espressif/kicad-libraries/template/ESP32-DevKitC/meta/board.png

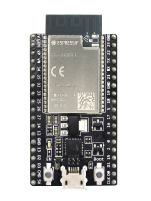
template/ESP32-DevKitC/meta/board.png
