espressif/kicad-libraries/template/ESP32-DevKitC/meta/module.png

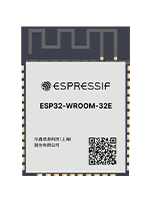
template/ESP32-DevKitC/meta/module.png
