espressif/kicad-libraries/(threads)

Thread 1 (2021-07-04):

Can you contribute the ESP32 library to the KiCad repository?

taotieren, 2021-07-04:
Can you contribute the ESP32 library to the [KiCad repository](https://gitlab.com/kicad/libraries)?

https://www.kicad.org/libraries/contribute/
https://www.kicad.org/libraries/klc/

pedrominatel, 2021-07-06:
Hi @taotieren, we are working on the first version of this library to include all commercial SoC and modules.
As soon as we have the first version available, we can do that.

taotieren, 2021-07-06:
I hope to contribute these libraries to the library warehouse before V6 is released, so that V6 users can directly use the ESP library to make PCB files

pedrominatel, 2021-07-06:
For sure @taotieren!

Closed 2021-07-15.

Thread 3 (2021-07-14):

Can't open footprint lib

TDA-2030, 2021-07-14:
## Environment

Application: KiCad
Version: 5.1.8-5.1.8, release build
Libraries:
    wxWidgets 3.0.3
    libcurl/7.66.0 OpenSSL/1.1.1d-fips zlib/1.2.11 libidn2/2.2.0 libpsl/0.20.1 (+libidn2/2.2.0) libssh/0.8.7/openssl/zlib nghttp2/1.40.0
Platform: Linux 5.3.18-lp152.78-default x86_64, 64 bit, Little endian, wxGTK
Build Info:
    wxWidgets: 3.0.3 (wchar_t,STL containers,compatible with 2.8) GTK+ 2.24
    Boost: 1.66.0
    OpenCASCADE Technology: 7.3.0
    Curl: 7.66.0
    Compiler: GCC 7.5.0 with C++ ABI 1011

Build settings:
    USE_WX_GRAPHICS_CONTEXT=OFF
    USE_WX_OVERLAY=OFF
    KICAD_SCRIPTING=ON
    KICAD_SCRIPTING_MODULES=ON
    KICAD_SCRIPTING_PYTHON3=OFF
    KICAD_SCRIPTING_WXPYTHON=ON
    KICAD_SCRIPTING_WXPYTHON_PHOENIX=OFF
    KICAD_SCRIPTING_ACTION_MENU=ON
    BUILD_GITHUB_PLUGIN=ON
    KICAD_USE_OCE=OFF
    KICAD_USE_OCC=ON
    KICAD_SPICE=ON

## Description

I can't open the footprint `Dev_ESP32-S2-Saola-1.kicad_mod` on commit `c8e7b4fa07bac0`. I guess the version is not compatible. Which version of kicad is used for testing?

Following is the error prompt:
```
11:27:22 AM: file '~/Desktop/kicad-libraries/footprints/Espressif.pretty/Dev_ESP32-S2-Saola-1.kicad_mod', line 1: '=' expected.
11:27:22 AM: file '~/Desktop/kicad-libraries/footprints/Espressif.pretty/Dev_ESP32-S2-Saola-1.kicad_mod', line 2: '=' expected.
11:27:22 AM: file '~/Desktop/kicad-libraries/footprints/Espressif.pretty/Dev_ESP32-S2-Saola-1.kicad_mod', line 3: '=' expected.
11:27:22 AM: file '~/Desktop/kicad-libraries/footprints/Espressif.pretty/Dev_ESP32-S2-Saola-1.kicad_mod', line 4: '=' expected.
11:27:22 AM: file '~/Desktop/kicad-libraries/footprints/Espressif.pretty/Dev_ESP32-S2-Saola-1.kicad_mod', line 5: '=' expected.
11:27:22 AM: file '~/Desktop/kicad-libraries/footprints/Espressif.pretty/Dev_ESP32-S2-Saola-1.kicad_mod', line 6: '=' expected.
11:27:22 AM: file '~/Desktop/kicad-libraries/footprints/Espressif.pretty/Dev_ESP32-S2-Saola-1.kicad_mod', line 7: '=' expected.

Omit similar logs
```

pedrominatel, 2021-07-14:
Hi @TDA-2030.

The library is now for the KiCad v6 (5.99).

My version is: Version: **5.99.0-unknown-395602b12a~131~ubuntu20.04.1, release build**

pedrominatel, 2021-07-14:
@TDA-2030 can you try the legacy branch?

https://github.com/espressif/kicad-libraries/tree/legacy

TDA-2030, 2021-07-15:
I have opened the footprint with KiCad v5.99. It should really be a version compatibility issue. Are the footprints of these two branches the same?

BTW, I'm adding `ESP32-DevKitc` and `ESP32-S3-DevKitc` to this library as well. If you think it is necessary, I will submit a PR :grin:

pedrominatel, 2021-07-16:
Hi @TDA-2030, thank you for collaborating!

For now, I'm using the `legacy` branch in order to be compatible with V5. Later, we can convert it easily to V6 or let the user do that.
The `feature/new_libraries` will not be updated anymore due to this compatibility issue with V5.

If you already managed to create the libs for the DevKitC on V6 version, you can create the PR on the `feature/new_libraries` and I can convert it back to V5 on the `legacy` branch. Otherwise I will close that branch and keep the `legacy` instead.

TDA-2030, 2021-07-16:
I will create the PR on `legacy` , because KiCad(v5.99) seems to work unsteadily on my computer.

Closed 2021-07-16.

Thread 5 (2021-07-18):

README is confusing

blackketter, 2021-07-18:
It's not clear when you arrive on the GitHub page for this library where the referenced footprints and symbols are.

I suggest that either:

The README.md should be updated to reference the appropriate branches
or

Include the 5.0-compatible files in the Main branch and leave the 6.0 versions in a branch to be merged later (after 6.0 is released)

or

Include folders for each major version of KiCAD in the Main branch

pedrominatel, 2021-07-18:
Thanks @blackketter for the feedback. We will improve that.

The `legacy` will be merged soon to main and all KiCad V6 libs will be removed.

Closed 2021-09-22.

Thread 8 (2021-07-26):

Document how to get 3D models working correctly

blackketter, 2021-07-26:
I see the 3d models in the repository, but they are not referenced correctly in the footprint files.  There seems to be a missing ${ESPRESSIF_3DMODELS} definition in the path.  This should be documented in the README as part of installation instructions.

Ideally, there would be a default relative path that would work without any further setup, but I don't think Kicad5 has a facility for this.

pedrominatel, 2021-07-27:
Thanks for the feedback. We'll include this step on README.

Closed 2021-09-22.

Thread 9 (2021-07-30):

Please add ESP-C3-32S

rtreffer, 2021-07-30:
Not sure if this is the right way to ask for it but I was hoping to see footprints for the ESP-C3-32S.

Please add a footprint for that chip (38p with 0.05mm less bottom space than the other WROOMS)

Spritetm, 2021-08-08:
That is an AI-Thinker product as far as I can see, not an Espressif product. You may be better off asking AI-Thinker for a symbol/footprint.

MauroMombelli, 2023-09-16:
@Spritetm if I make a merge request, would it be accepted or this repo is only for official layout?

Spritetm, 2023-09-17:
@MauroMombelli I'm no the owner of this repo, but I don't think so... it would be very hard for us to check and maintain footprints for products that are not ours.

Closed 2021-08-08.

Thread 10 (2021-08-05):

Symbol ESP32-S3-WROOM-1 wrong name

TDA-2030, 2021-08-05:
## Description
The two names in the red box are different
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

pedrominatel, 2021-08-10:
Thanks for pointing this out @TDA-2030. This will be fixed soon.

pedrominatel, 2021-08-10:
PTAL @TDA-2030 before merging.

https://github.com/espressif/kicad-libraries/pull/13

TDA-2030, 2021-08-11:
LGTM :)

Closed 2021-08-12.

Thread 15 (2021-08-21):

WROOM and WROVER symbols are swapped

hhtat, 2021-08-21:
The ESP32-WROOM-E and ESP32-WROVER-E symbols seems to be swapped. This can be verified by looking at GPIO16 & GPIO17. On WROVER these should be NC (due to PSRAM) but are connected. On WROOM these should be connect but marked NC.

pedrominatel, 2021-08-21:
Thanks for reporting this issue @hhtat

Closed 2021-08-21.

Thread 18 (2021-10-11):

Can you add the library about ESP32-C3-MINI-1U and ESP32-C3-WROOM-02U

McflyWZX, 2021-10-11:
Although they have the same symbol with which module not "U", but their footprint and the 3D model are not same. That will make many help!

pedrominatel, 2021-11-02:
New footprint added, PTAL @McflyWZX.

McflyWZX, 2021-11-03:
Very thank you

Closed 2021-11-02.

Thread 22 (2021-11-02):

ESP32-S3-MINI-1 symbol references "ESP32-S3-WROVER"

atanisoft, 2021-11-02:
A rather minor issue in the symbol:
https://github.com/espressif/kicad-libraries/blob/b40df1bc7486e5b6350e0c265a6b5adb9419a549/libraries/Espressif.lib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

pedrominatel, 2021-11-05:
Thanks for your feedback @atanisoft. This will be fixed soon.

Closed 2021-11-10.

Thread 24 (2021-11-18):

ESP32-S3-MINI-1 footprint pad 46 not connecting to GND net

atanisoft, 2021-11-18:
All GND pads connect except the non-square pad in the center:
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

Checking that specific pad shows that it is explicitly configured to not connect to nets.

pedrominatel, 2021-11-19:
Thank you for your feedback. I'll check it ASAP.

pedrominatel, 2021-11-19:
Hi @atanisoft, KiCad does not support thermal relief on custom shape pads. You can add manually or edit the pad characteristics by double-clicking on the custom pad and setting.

Pad Properties -> Connection to Copper Zone -> Pad Connection -> Solid

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

If this works for you, you can close this issue.

Thank you!

atanisoft, 2021-11-19:
@pedrominatel That is rather unfortunate on the KiCad side, but understandable considering the reason why (thermal relief spokes would be challenging to calculate on random polygons). After reading your suggestion I went looking for options to augment the footprint so it can fill automatically like others and one suggestion was to add a second pad (square or circle) that is smaller than the custom pad and stack them. I'll see if I can modify the footprint to have a smaller pad on top of this one and confirm if it works and doesn't generate any unnecessary DRC alerts.

pedrominatel, 2021-11-19:
This smaller pad technique works very well in most of the cases. If you want, you can create a PR for the S3 and we can replicate it for the others.

atanisoft, 2021-11-19:
I'll send a PR in a bit after confirming no DRC related alerts

atanisoft, 2021-11-19:
@pedrominatel in my testing of stacked footprints locally it doesn't seem to connect to the copper fill. I'm thinking your alternative above may be a better option and include it by default in the footprint.

Minimal diff:
```
   (pad 46 smd custom (at -1.65 -1.65) (size 0.6 0.6) (layers F.Cu F.Paste F.Mask)
-    (zone_connect 0)
+    (zone_connect 2)
```

For whatever reason KiCad wants to reorder all of the `fp_line` entries in the footprint which makes little sense since they are the same values just reordered.

pedrominatel, 2021-11-22:
Hi @atanisoft, I can modify that in my next review. I think it's a good idea to add some notes about it on the `README.md` in order to explain this KiCad 5 limitation. Not sure if this happens on KiCad 6.

Closed 2021-12-01.

Thread 25 (2021-11-23):

ESP32-WROOM-32E GPIO 16 and GPIO 17 have no connection flags

Monacrylic, 2021-11-23:
IOs 16 and 17 have a no connection flag, while they shouldn't (looking at the datasheet).

pedrominatel, 2021-12-13:
Fixed! Thank you @Monacrylic

Closed 2021-12-13.

Thread 26 (2021-11-23):

ESP32-C3-WROOM-02U 3D model

BitSalat, 2021-11-23:
Would be great to have a 3D model (step) for the -02U module (without PCB antenna)
as well as we are just implementing it in a commercial design - thank you a lot.

alank-hisky, 2021-11-23:
Found a possible 3rd party solution "ESP-WROOM-02U" STEP file
https://www.3dcontentcentral.com/secure/download-model.aspx?catalogid=171&id=999269
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

pedrominatel, 2022-01-19:
The 3D model will be added on the next revision.

Here is the 3D model: https://www.espressif.com/sites/default/files/3dmodel/ESP32-C3-WROOM-02U_20210906_0.STEP

pedrominatel, 2022-03-04:
Done!

Thread 29 (2021-12-27):

Prepare KiCad 6 port

pedrominatel, 2021-12-27:
Prepare libraries to KiCad 6.

- Test current libraries.
- Convert to KiCad 6.
- Test

atanisoft, 2021-12-31:
In my limited testing so far with KiCad 6 the libs appear to be working without problems.

pedrominatel, 2022-01-10:
Thank you for testing @atanisoft! I'm also testing without any problems so far.

Closed 2022-03-04.

Thread 40 (2022-04-13):

No ground for exposed pad (pin 39) on schematic symbol

crashmatt, 2022-04-13:
How to connect pin 39 GND?
The ESP32-S2-WROOM schematic and footprint has this option on pin 43.

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

crashmatt, 2022-04-13:
Fixed in the KiCad V6 library.  Closing.

Closed 2022-04-13.

Thread 41 (2022-04-26):

ESP32-S3-WROOM-1 has wrong pin label

Li-Huakang, 2022-04-26:
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
duplicated

pedrominatel, 2022-05-02:
Thanks, @Li-Huakang for your collaboration!

Closed 2022-05-02.

Thread 44 (2022-05-08):

do you can add altium libraries for it

yuyue2013, 2022-05-08:
I use the altium for drawing board.  but the esp32 don't have the altium libraries. do you can add altium libraries of esp32?  thanks!

TianmingLi, 2022-05-24:
if you use altium, you can get everything from [lceda](https://lceda.cn/editor). also there are lot tutorial for how to do it.

pedrominatel, 2022-06-15:
Hi,

Espressif does not have any plans in the near future for adding the Altium libraries.

Closed 2022-06-15.

Thread 46 (2022-06-23):

ESP32-WROOM symbol description wrong (describes the WROVER)

ESP-Marius, 2022-06-23:
The ESP32-WROOM symbol description seems to be a copy of the WROVER description.

pedrominatel, 2022-06-23:
Thanks @ESP-Marius, I'll fix it ASAP.

Closed 2022-07-11.

Thread 49 (2022-07-01):

ESP32-S3-WROOM2

higaski, 2022-07-01:
Any chance we can expect the WROOM2 versions of the S3 modules any time soon? From what I've seen they have slightly rearranged ground pads in the middle compared to the WROOM1.

pedrominatel, 2022-07-11:
Hi @higaski,

The [ESP32-S3-WROOM-2](https://www.espressif.com/sites/default/files/documentation/esp32-s3-wroom-2_datasheet_en.pdf) will be added according to the datasheet landing pattern.

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

higaski, 2022-07-11:
Ok, let me rephrase my question.

In case I need a footprint of this part within the next 2-3 weeks, should I better draw it myself or can I count on you guys doing it. :stuck_out_tongue_closed_eyes:

pedrominatel, 2022-07-11:
We can manage that in the next week or soon.

pedrominatel, 2022-07-29:
Done, @higaski. PTAL

Closed 2022-07-29.

Thread 50 (2022-07-07):

Fix ESP32-C3-MINI-1/U modules outline dimensions

pedrominatel, 2022-07-07:
[Datasheet](https://www.espressif.com/sites/default/files/documentation/esp32-c3-mini-1_datasheet_en.pdf)

Related to #48

pedrominatel, 2022-07-08:
Fixed on PR #48

Closed 2022-07-08.

Thread 56 (2022-08-21):

esp32-mini-1 symbol / footprint

tenderlove, 2022-08-21:
Hi,

I'm working on a project that incorporates the [esp32-mini-1](https://www.espressif.com/sites/default/files/documentation/esp32-mini-1_datasheet_en.pdf), and I was wondering if there is a KiCad symbol / footprint available for that module?  I don't see one in this repository, but I would be happy to make one if there is a similar module I can copy from.

Any help would be greatly appreciated.

Thanks!

pedrominatel, 2022-08-23:
Thanks, @tenderlove. We can provide the new footprint/symbol for this new module.
This module has a different landing pad number from all the other MINI versions. Copy is not possible.

tenderlove, 2022-08-23:
@pedrominatel awesome, thank you!!! 😍

tenderlove, 2022-10-10:
@pedrominatel thanks for fixing this!  I don't see the mini-1 in the repo though.  Am I missing something?  Thanks.

Closed 2022-10-28.

Thread 57 (2022-09-02):

Adherence to KiCad Library Conventions

JustinOng, 2022-09-02:
Hello,

Can I find out if there are plans to have the symbols to adhere to the [KiCad Library Conventions](https://klc.kicad.org/symbol/)? The two specifically I've noticed on the ESP32-WROOM-E:

- S4.1, point 1, where the pin origin should lie on a 100mil grid
- S4.3, point 3, where pins of the same type (mostly GND) should be stacked together

pedrominatel, 2022-09-26:
Hi @JustinOng, thank you for the concern. I'll review this issue and make the changes.

pedrominatel, 2022-10-31:
Can you take a look at PR #61, @JustinOng?

Closed 2022-11-02.

Thread 58 (2022-09-11):

Models for ESP32-S3-MINI-1U and ESP8684-MINI-1-H4

GTCLive, 2022-09-11:
Hi guys, would it be possible to update this repo with the latest step files for S3 and C2, please?
Those are the modules we've recently bought and can't find them in the repo.
No rush neither an impediment in getting PCB done.
Would be nice to have that's all.
Thanks

ESP32-S3-MINI-1U
ESP8684-MINI-1-H4
ESP8684-WROOM-01C-H4

pedrominatel, 2022-10-31:
Done, @GTCLive.

Closed 2022-10-29.

Thread 59 (2022-10-11):

3D model of ESP32-S3-WROOM-1U

dangvitin, 2022-10-11:
I think the 3D model for **ESP32-S3-WROOM-1U** is not correct.

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

pedrominatel, 2022-10-25:
Thank you @dangvitin, for reporting this issue.
I'll take a look.

pedrominatel, 2022-10-28:
Hi,

In fact, this 3D model is the wrong one and will be removed from the 3D folder. The correct one will be uploaded as soon as possible.

Closed 2023-01-03.

Thread 62 (2022-11-07):

Thermal pads of ESP32-WROOM-E at wrong location?

timcooijmans, 2022-11-07:
Hi,

Our PCBA house noted a mismatch (both in X and Y location as size) between the thermal pads of ESP32-WROOM-E in this library and the datasheet (in red):
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

Footprint 8.32mm to center of thermal pads:
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

Datasheet 7.5mm to center of thermal pads:
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

Same applies in the vertical direction and the size of the pads themselves.

pedrominatel, 2022-11-21:
Thank you, @timcooijmans,  for your feedback. This issue has been fixed and merged.
Please check it out.

Closed 2022-11-21.

Thread 65 (2022-12-07):

Feature Request: Add KICAD Library to Offical PCM (Package and Plugin Manager)

philippdonabauer, 2022-12-07:
### Kicad PCM (Plugin and Content Manager) Feature Request

Kicad now provides the possibility to add custom footprint / content libraries to a Plugin Manager. This provide the users the possibility to simple install Offical released versions of your content library. It also helps you to be one of the first "microcontroller" on the platform that also means that you can arrive more and new customers.

Here an screenshot of the library manager, which i think is one of the biggest new features:

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

The documentation is simple to understand: https://dev-docs.kicad.org/en/addons/

I would love to see this package in the plugin manager in the future. I maybe also can help a little bit if you don't have the time to do that.

Thank you very much.

pedrominatel, 2022-12-12:
Hi @philippdonabauer,

This has been on my to-do list for a while. I'll start working on that by Jan/Feb 23.

pedrominatel, 2022-12-19:
Hi, @philippdonabauer. It will be great if you contribute to this project! Go ahead!
Many thanks for your help!

dronecz, 2023-01-17:
@philippdonabauer Any progress with this? Many thanks for your work! :heart:

cooked, 2023-01-30:
@philippdonabauer I've developed a gitHub action to automate packaging of Kicad addon... maybe it can help your case. let me know if you try it out and need help
https://github.com/marketplace/actions/publish-kicad-addon

cheers

pedrominatel, 2023-02-07:
Thank you @philippdonabauer for your help!

As I understood, you are able to install via the ZIP file but you can't find the package in the libraries search, is that correct?

pedrominatel, 2023-02-07:
One good example we can follow is the `keyswitch-kicad-library` from @perigoso: https://github.com/perigoso/keyswitch-kicad-library

Is there anything you can help us with, @perigoso?

perigoso, 2023-02-07:
Hi, probably, but i would need to understand the problem first, I'll take a look at the end of the day

perigoso, 2023-02-10:
Sorry, I didn't have time and then forgot...

I'm sorry to inform you I have nothing to add. :sweat_smile:

Your branch looks good, the generated package has the correct structure and everything looks good, it installs and I can find the libraries just fine.

Do make sure the libraries are in the footprint and symbol library tables, in Preferences, when the feature was added libraries were not added automatically, but right now I think they are supposed to.

perigoso, 2023-02-22:
IMO the patch is good to go as is, the problem is either a bug on the version of KiCad you are using or some configuration issue

JarrettR, 2023-04-19:
Hi,

Is this good to just create a PR?

JarrettR, 2023-04-20:
Works fine on Windows

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

Added quick rough directions on how to submit to KiCad. It's from memory, so it's possible it's not fully complete, but the gist of it is there.

Closed 2023-06-07.

Thread 67 (2023-01-07):

ESP32-C3-MINI-1 missing pin 11 & 14

shanemmattner, 2023-01-07:
I keep getting errors for missing `pin 11/14`.

```
Warning: No net found for symbol U1 pin 14.
Warning: No net found for symbol U1 pin 11.
```

Upon inspecting the schematic symbol I think these pins are missing and should be with the rest of the ground pins:

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

Closed 2023-01-10.

Thread 71 (2023-01-20):

Fix the KLC S4.2 for all symbols

pedrominatel, 2023-01-20:
Fix the pin grouping rule for all symbols.

https://klc.kicad.org/symbol/s4/s4.2/

Reference: #70

Closed 2024-04-22.

Thread 74 (2023-01-30):

ESP32-WROOM symbol missing GND pins

cooked, 2023-01-30:
library version 1.1.0 pin missing:
- pin 15
- pin 38

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

pedrominatel, 2023-01-31:
Hi,

All GND pins are grouped together and just one is visible. You can see the symbols in the full pin list.

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

Closed 2023-01-31.

Thread 77 (2023-02-18):

Off grid pin 9 in ESP32-C3-WROOM-02 symbol

sevesalm, 2023-02-18:
Pin 9 in ESP32-C3-WROOM-02 symbol has off grid x position. Gives the following warning in KiCad 7 symbol editor: `Off grid pin 9 'GND' at location (-0.0054 mm, 27.9400 mm). I guess it should just be 0 mm.

The affected line:
https://github.com/espressif/kicad-libraries/blob/main/libraries/Espressif.kicad_sym#L739

pedrominatel, 2023-02-20:
Thank you for your report, @sevesalm! We'll take care ASAP.

Closed 2023-03-02.

Thread 78 (2023-02-22):

Keepout zones over antenna regions

DanielVoogsgerd, 2023-02-22:
In the datasheets for various modules one can find that there is a keepout zone where the antenna is, this makes sense. However, I don't see such a keepout zone in the footprints. Is this for a specific reason I'm not seeing? If it isn't, it might be a good addition to the footprints.

pedrominatel, 2023-02-23:
Hi @DanielVoogsgerd,

I believe this will bring good value to the designers. I'll add the keepout zones for the new fp's and review/bug fix the others.

DanielVoogsgerd, 2023-02-23:
Terrific, if I can be of any assistance feel free to say so. I suspect however that reviewing the keepout zones would be about as much work as drawing them. If it isn't I'm happy to create a PR with the changes.

Closed 2023-05-19.

Thread 81 (2023-03-12):

ESP32-S3-WROOM-1U Symbol

unixb0y, 2023-03-12:
I noticed there is no dedicated symbol for ESP32-S3-WROOM-1U.
Are we supposed to just choose the ESP32-S3-WROOM-1 (without **U**) symbol and change the footprint to ESP32-S3-WROOM-1U? It does seem to work.

Just trying to clarify whether intentional or not.

pedrominatel, 2023-04-18:
Hi @unixb0y,

Both are pin-to-pin compatible, so there is no need to add a new symbol.
We can add a note in the description or change the name to ESP32-S3-WROOM-1/U.

cmcskimming, 2024-02-16:
It would be nice to just have the U variant in the list of options, not having it just adds the extra step of having to edit the symbol and change its footprint to 1U. I'm sure the extra space it takes up would not be an issue for most people when the 1U footprint is already present in the library anyway.

pedrominatel, 2024-02-22:
Hi @cmcskimming,
The extra antenna area is set as keepoout zone. If you need the 1U for some extra space and place the module somewhere that is not on the border of the PCB, you will be not able to use the antenna area.
The most common FP is the U variant, and it's set as default.

Thread 84 (2023-03-28):

Please check ESP32-S3-DevkitC footprint

korneliuszo, 2023-03-28:
It looks like header spacing is wrong

korneliuszo, 2023-03-28:
Found issue - https://sklep.msalamon.pl/produkt/plytka-esp32-esp32-s3-devkit-wifi-ble-5-0/ which I've bought is not original board.

Closed 2023-03-28.

Thread 87 (2023-04-05):

Add ESP8685-WROOM-05 library

caetanowagner, 2023-04-05:
Add ESP8685-WROOM-05 library.

Artain, 2025-03-17:
I created a footprint. Feel free to use it.

[ESP8685-Wroom-05.zip](https://github.com/user-attachments/files/19277319/ESP8685-Wroom-05.zip)

Thread 90 (2023-04-21):

Plans for ESP32-C6-MINI-1U?

jessebraham, 2023-04-21:
The `ESP32-C6-MINI-1` has a symbol/footprint, however there does not appear to be a footprint for the `U` variant of this module. Were there plans to add this?

pedrominatel, 2023-04-26:
Hi @jessebraham,

Yes, the `U` variant will be supported by this library soon. The footprint will be pin-to-pin compatible with the `non-U` variant.

jessebraham, 2023-04-26:
Awesome, thanks Pedro!

Closed 2023-05-25.

Thread 91 (2023-05-07):

add WT32-S3-WROVER please

alphaonex86, 2023-05-07:
Hi,
Can you add WT32-S3-WROVER please?
The S2 seam not pin to pin compatible. I search in particular WT32-S3-WROVER-N4
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

alphaonex86, 2023-05-10:
No problem, I thinks S3 was official module.

Closed 2023-05-10.

Thread 96 (2023-05-22):

plan for ESP32-C6-DevKitM-1 ?

tomlevisse, 2023-05-22:
Are you going to add ESP32-C6-DevKitM-1 to the library ?

tomlevisse, 2023-06-05:
3D model will be available in this issue ?

pedrominatel, 2023-10-13:
For reference: [ESP32-C6-devkitm-1-user_guide](https://docs.espressif.com/projects/espressif-esp-dev-kits/en/latest/esp32c6/esp32-c6-devkitm-1/user_guide.html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)

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

tomlevisse, 2023-10-13:
@pedrominatel is it possible to add the 3D shape?

Closed 2023-11-17.

Thread 109 (2023-06-22):

Add 3D Model for ESP32-S2-SOLO

marcidy, 2023-06-22:
Please update the ESP32-S2-SOLO footprint to include a reference to the 3D model.

Since it's geometrically compatible with the WROOM, I modified a local copy to include:

```
  (model "${ESPRESSIF_3DMODELS}/ESP32-S3-WROOM-1.STEP"
    (opacity 0.7500)    (offset (xyz -9 -9.75 0))
    (scale (xyz 1 1 1))
    (rotate (xyz 0 0 0))
  )

```

which worked for my purposes

e.g., from KiCAD:

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

Thanks!

Closed 2023-06-29.

Thread 112 (2023-06-30):

Archive does not contain a valid metadata.json file

muscatelle, 2023-06-30:
I've just tried to install this version on kicad 7.05 as listed below and get an error message:
"Archive does not contain a valid metadata.json file"

Tony

Application: KiCad x86_64 on x86_64

Version: 7.0.5-7.0.5~ubuntu22.04.1, release build

Libraries:
	wxWidgets 3.2.1
	FreeType 2.11.1
	HarfBuzz 6.0.0
	FontConfig 2.13.1
	libcurl/7.81.0 OpenSSL/3.0.2 zlib/1.2.11 brotli/1.0.9 zstd/1.4.8 libidn2/2.3.2 libpsl/0.21.0 (+libidn2/2.3.2) libssh/0.9.6/openssl/zlib nghttp2/1.43.0 librtmp/2.3 OpenLDAP/2.5.14

Platform: Ubuntu 22.04.2 LTS, 64 bit, Little endian, wxGTK, KDE, x11

Build Info:
	Date: May 31 2023 23:56:22
	wxWidgets: 3.2.1 (wchar_t,wx containers) GTK+ 3.24
	Boost: 1.74.0
	OCC: 7.5.2
	Curl: 7.88.1
	ngspice: 38
	Compiler: GCC 11.3.0 with C++ ABI 1016

Build settings:
	KICAD_SPICE=ON

UnexpectedMaker, 2023-07-02:
Getting the same - KiCAD 7.0.5 on macOS.

pedrominatel, 2023-07-03:
Hi,

Could you please confirm (unzipping) if the zip file contains the `metadata.json`? Can you send me the link that you are using to download the file?

UnexpectedMaker, 2023-07-03:
> Hi,
>
> Could you please confirm (unzipping) if the zip file contains the `metadata.json`? Can you send me the link that you are using to download the file?

It does have the `metadata.json` file in the archive, but KiCAD 7.05 (at least on the Mac) doesn't like it.

I'm using the releases link form the releases page...
https://github.com/espressif/kicad-libraries/releases/download/2.0.0/espressif-kicad-addon.zip

Cheers :)

pedrominatel, 2023-07-03:
I've tested right now on macOS Monterey (12.5) Apple M1 chip and it worked on KiCad 7.0.5.
I'll ask someone else with macOS to test it and see if we can identify the issue.

Anyway, I'll release a new version (2.0.1) with some fixes later today. Maybe you can try with the new zip file.

Hi-Rob, 2023-07-03:
Hi I got the same error on win7
there were a metadata.json file in the .zip

pedrominatel, 2023-07-03:
Could you please test this pre-release 2.0.1 version?

https://github.com/espressif/kicad-libraries/releases/download/2.0.1/espressif-kicad-addon.zip

UnexpectedMaker, 2023-07-03:
> Could you please test this pre-release 2.0.1 version?
>
> https://github.com/espressif/kicad-libraries/releases/download/2.0.1/espressif-kicad-addon.zip

Doesn't work...
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

2023 16" MacBookPro with M2 MAX running macOS 13.4.1 and KiCAD 7.0.5

Hi-Rob, 2023-07-03:
The addon

> Could you please test this pre-release 2.0.1 version?
>
> https://github.com/espressif/kicad-libraries/releases/download/2.0.1/espressif-kicad-addon.zip

This worked to me

muscatelle, 2023-07-10:
Now works for me also using KiCad x86_64 on x86_64 on 7.0.5-7.0.5~ubuntu22.04.1, release build

Thanks

murarduino, 2023-07-10:
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

zip file:
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

serant, 2023-08-10:
I think I have a way to reproduce this issue.

I had the same issue when downloading v2.0.1 using **Safari** on my MacBook which automatically unzips the folder after downloading. I re-zipped the folder and ran into the issue described in this thread when importing the library.

I then disabled "Open "safe" files after downloading" in Safari's preferences to prevent the zip files from automatically being extracted because I had a feeling that me re-zipping the files was causing an issue. This time v2.0.1 works flawlessly!

UnexpectedMaker, 2023-08-10:
@serant Well done! That was it!

pedrominatel, 2023-08-16:
This explains the issue. The GitHub CI generates the ZIP file and contains the file hash inside the ``metadata.json`` file to make sure the file is not corrupted or something else. If you unzip and zip again, the hash will differ from the one inside the metadata.

This issue is not related to the library itself. Thank you @serant for describing it.
I'll close this issue in 24 hours if there is no more activity here.

Closed 2023-08-17.

Thread 113 (2023-07-15):

missing the SoC footprints :)

ESP32DE, 2023-07-15:
missing the SoC footprints :)

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

pedrominatel, 2023-07-15:
Hi @ESP32DE

For the SoC, the footprint used is from the default KiCad library, as you can see here:

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

ESP32DE, 2023-07-15:
hi @pedrominatel thanks
i used kicad 7 without the default KiCad library for a test - ( just only 140 Mb, with the default KiCad library 1.1GB  )
i will cpy the parts from the default KiCad library 6 and convert them .
thanks

Closed 2023-07-15.

Thread 114 (2023-07-17):

no footprint found for ESP32-S3-WROOM

beta-tester, 2023-07-17:
i installed the espressif-kicad-addon.zip file from Espressif KiCad Library v2.0.1 to KiCAD 7
but for the ESP32-S3-WROOM modules there is no footprint found.
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

beta-tester, 2023-07-17:
ok, found the footptint.
i thought the footprint is always linked with the symbol. but this symbol/footprint is not.
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

Closed 2023-07-17.

Thread 116 (2023-07-27):

Footprints of the boards not showing on the schematic page or getting converted in the PCB Editor

Eraldo404, 2023-07-27:
Hello, so as mentioned in the title I'm having a problem working with the footprints of the esp32 included in the library. When choosing a board from the schematic page it doesn't show the footprint of the board in the small window, and when placing that component on the schematic and then converting that schematic into the PCB editor, it doesn't get converted at all.

The weird thing though is that if you were to import the footprint directly from the PCB Editor as a reference it works just fine even with the 3D model viewer. Another interesting thing is that this is happening only to the encapsulated boards or devboards and the single esp32 ic's (the non encapsulated ones) have their footprint working fine.

I'm a beginner in kicad so if i'm making a mistake on my part please tell me.

-The version of the library i'm using:

                Espressif KiCad Library v2.0.1

-The version of kicad i'm using (updated today in hope of it fixing by itself):

                Application: KiCad Schematic Editor x64 on x64
        
                Version: 7.0.6, release build
        
                Libraries:
	                wxWidgets 3.2.2
	                FreeType 2.12.1
	                HarfBuzz 6.0.0
	                FontConfig 2.14.1
	                libcurl/7.88.1-DEV Schannel zlib/1.2.13
        
                Platform: Windows 10 (build 19045), 64-bit edition, 64 bit, Little endian, wxMSW
        
                Build Info:
	                Date: Jul  6 2023 04:56:45
	                wxWidgets: 3.2.2 (wchar_t,wx containers)
	                Boost: 1.81.0
	                OCC: 7.6.3
	                Curl: 7.88.1-DEV
	                ngspice: 40
	                Compiler: Visual C++ 1936 without C++ ABI
        
                Build settings:
	                KICAD_SPICE=ON

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

Thatonedragon, 2023-08-03:
A temporary bypass is putting them in local libraries

Thread 117 (2023-09-02):

Footprint library name is wrong

olup, 2023-09-02:
KiCad cannot find footprint for all specific-made ones. Points to `Espressif/` when it's actually named `PCM_Espressif/`

pedrominatel, 2023-09-04:
Thank you for reporting this issue. We will work to fix it ASAP.

Closed 2023-09-10.

Thread 118 (2023-09-05):

disgusting symbol error on esp32-s2

chopin1998, 2023-09-05:
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

 unbearable.

chopin1998, 2023-09-11:
thank you!

Closed 2023-09-10.

Thread 123 (2023-10-09):

Which footprint for ESP32-S3-PICO-1

lclaude, 2023-10-09:
Hello,
I'm not sure which footprint to use with the SoC ESP32-S3-PICO-1.
In the datasheet the package is LGA56 (7x7mm), I can't find an equivalent in your footprints.
Thanks by advance.

pedrominatel, 2023-10-10:
Hi @lclaude,

You can use the **QFN-56 1EP 7x7mm P0.4mm EP4x4mm** from the official KiCad library.

**QFN-56-1EP_7x7mm_P0.4mm_EP4x4mm**

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

Equivalent to the LGA-56

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

lclaude, 2023-10-10:
OK, I'll test with this one. Thank you.

Closed 2023-10-10.

Thread 124 (2023-10-12):

Any plans for the ESP32-C3-DevKitM-1?

electron271, 2023-10-12:

pedrominatel, 2023-10-13:
Hi @electron271, we can add it.

[ESP32-C3-user-guide-devkitm-1](https://docs.espressif.com/projects/esp-idf/en/latest/esp32c3/hw-reference/esp32c3/user-guide-devkitm-1.html)

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

electron271, 2023-10-13:
Thanks! I normally would have made a PR, however I am very bad at making KiCad footprints

pedrominatel, 2023-10-15:
Don't worry!

electron271, 2023-10-29:
Looked at PR, the footprint seems fine, haven't tested the symbol yet though

pedrominatel, 2023-10-31:
I'll merge soon.

Closed 2023-11-17.

Thread 125 (2023-10-15):

Installation Fails (Invalid metadata.json) at 30d68f4b1e6c087a6616d102685d909818abab9c

shanedoolane, 2023-10-15:
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

Kicad version: `6.0.11`

shanedoolane, 2023-10-15:
Was installing from main branch instead of release. Worked after downloading from https://github.com/espressif/kicad-libraries/releases/tag/2.0.3

Closed 2023-10-15.

Thread 127 (2023-10-22):

GPIO11 in ESP32-C6-WROOM-1

david-varela, 2023-10-22:
The ESP32-C6-WROOM-1 symbol has some pins as invisible. One of those is the pin **GPIO11**, pin number 12, of type bidirectional, which **is placed in the same position as the grounds**, pins number 1, 28 and 29. See details in the table below:

| Pin name | Pin number | Electrical type | Visible | X position | Y position |
| --- | --- | --- | --- | --- | --- |
| GND | 1 | Power input | Yes | 0 | 33.02 |
| GPIO11 | 12 | Bidirectional | No | 0 | 33.02 |
| GND | 28 | Passive | No | 0 | 33.02 |
| GND | 29 | Passive | No | 0 | 33.02 |

I believe, looking at the [datasheet](https://www.espressif.com/sites/default/files/documentation/esp32-c6-wroom-1_wroom-1u_datasheet_en.pdf), that the pin number 12 should be visible and in a different location, am I right? Right now, when I connect pin number 1 to ground of my battery, the rules checker shows a warning for connecting pin  number12 to ground, because pin number 12 is invisible and shares the location with pins 1, 28 and 29.

pedrominatel, 2023-10-22:
Thank you @david-varela for reporting this issue.
Fixed and new version released! Please update to the version 2.0.4.

david-varela, 2023-10-22:
Thank you @pedrominatel for the fix and the new release!

Closed 2023-10-22.

Thread 132 (2023-11-14):

Kicad 7.0.6->Archive does not contain a valid metadata.json file

meakashrao, 2023-11-14:
Hello, I tried to install from Main Release or Branch Release and metadata error keeps popping up.

Please advise what to do.
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

Regards,
Akash Rao

pedrominatel, 2023-11-14:
Hi,
Can you check this issue #105 if it is related to yours?

meakashrao, 2023-11-14:
No, I don't think so, I went ahead and downloaded 7.0.9 Kicad, could you please help me with the latest release branch so that I can try that out

meakashrao, 2023-11-14:
https://github.com/espressif/kicad-libraries/releases/tag/2.0.4

We'll sorry this did work for me.

Thanks for the help

Closed 2023-11-14.

Thread 134 (2023-11-22):

Symbol and Footprint for ESP32-C3-DevKitC-02

dougli1sqrd, 2023-11-22:
It looks like there are symbols and footprints for the ESP32-C3-DevKitM, but I would also love to have available the DevKitC, user guide linked here: https://docs.espressif.com/projects/esp-idf/en/latest/esp32c3/hw-reference/esp32c3/user-guide-devkitc-02.html.

Are there any plans to make this symbol/footprint?

pedrominatel, 2023-11-23:
Hi @dougli1sqrd, we can add the DevKitC.
Thanks!

Closed 2024-02-09.

Thread 136 (2023-11-27):

metadata.json is missing in the release files

muexxl, 2023-11-27:
I just downloaded the release file 2.0.5.  and got an import error "... metadata.json is missing".
I was able to create the metadata.json file by cloning the package and running the package.py script.
You may want to include the metadata.json file in future releases.

Joebeazelman, 2023-11-27:
Interesting. I downloaded the zip file and it contains the metadata.json, but couldn't get KiCad 7 to open it from MacOS.

pedrominatel, 2023-11-28:
Please take a look at https://github.com/espressif/kicad-libraries/issues/112

pedrominatel, 2023-12-27:
Closing the issue. Related to the issue #137.

Closed 2023-12-27.

Thread 137 (2023-11-27):

Can't install library in Kicad 7 for MacOS

Joebeazelman, 2023-11-27:
I'm running macOS Sonoma and KiCad 7.0. I've downloaded the latest KiCad Library addon zip file (version 2.0.5) and tried to install it using **Install from File...** from the **Plugin and Content Manager**. I was able to see a grayed out  **metadata,.json**, but I was unable to select it.

I thought it may be installed automatically, but I didn't see the library installed.

Please advise?

pedrominatel, 2023-11-28:
Hello,
Are you using Safari to download the ZIP file?

PTAL https://github.com/espressif/kicad-libraries/issues/112

jacobnrohan, 2023-11-28:
Is there a suggested solution? #112 doesn't specify a solution.

I've download using both `github.com -> download ZIP` and using `git clone https://github.com/espressif/kicad-libraries` and re-zipping the file. Both methods result in **Archive does not contain a valid metadata.json** error message in Kicad 7.0.7. The same is true after I upgraded to Kicad 7.0.9.

pedrominatel, 2023-11-28:
Have you tried this [file](https://github.com/espressif/kicad-libraries/releases/download/2.0.5/espressif-kicad-addon.zip) from the assets, @jacobnrohan?

ariyyyaaannn, 2023-12-11:
macOS automatically unzips compressed files when downloaded. If you 'rezip' this folder, you get the following file structure:

```
>espressif-kicad-addon.zip
   >espressif-kicad-addon
      >3dmodels
      >footprints
      >metadata.json
      >....

```

As @jacobnrohan mentioned, You need the contents of the 'espressif-kicad-addon' to be at the root of the .zip file. Instead, select the contents of the downloaded folder and recompress them into a new .zip file. This is the desired structure:

```
>Archive.zip
   >3dmodels
   >footprints
   >metadata.json
   >....
```

You should be able to upload this new archive to the Kicad PCM with no issue.

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

pedrominatel, 2023-12-13:
Hi @ariyyyaaannn,

Thank you for the detailed explanation. This information about Safari "Open safe..." preference will be included on the README file soon.

pedrominatel, 2023-12-27:
Closing this issue. Now we have a note on the readme.

Closed 2023-12-27.

Thread 138 (2023-12-17):

ESP32-S2-Saola-1 wrong pin label for GPIO17 & 18

julianobst, 2023-12-17:
Looks like the symbol for ESP32-S2-Saola-1 has wrong pin labels for GPIO 17 and GPIO18.
According to the online [documents ](https://docs.espressif.com/projects/esp-idf/en/latest/esp32s2/hw-reference/esp32s2/user-guide-saola-1-v1.2.html):
GPIO17: ADC2_CH6, DAC_1
GPIO18: ADC2_CH7, DAC_2, RGB LED

the datasheet for the S2 confirms this
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

But the library symbol has crossed DAC and ADC channels for these GPIOS:
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

I would like to provide a pr if you confirm this issue :-).

julianobst, 2023-12-17:
This issue also seems to be relate to other S2 based symbols:
- ESP32-S2-MINI-1_1_1 (ESP32-S2-MINI-1)
- ESP32-S2-Saola-1_0_0 (ESP32-S2-Saola-1)
- ESP32-S2-WROOM_1_1 (ESP32-S2-WROOM (NRND)
- ESP32-S2-WROVER_0_0 (ESP32-S2-WROVER (NRND)

Closed 2023-12-26.

Thread 139 (2023-12-19):

Missing 3D model of ESP32-S3-MINI-1U

ONLYA, 2023-12-19:
I found that there was an issue related to this model: #58 . However, I cannot find the 3D model for ESP32-S3-MINI-1U in the repo now even if it was said to be done.
If the model was there but got deleted during version branch transition, could you please add them back to the library?

pedrominatel, 2023-12-28:
Done, @ONLYA. Please take a look at the release v2.0.6.

ONLYA, 2023-12-28:
> Done, @ONLYA. Please take a look at the release v2.0.6.

Thank you pedrominatel!

Closed 2023-12-27.

Thread 142 (2024-01-02):

KiCAD error. Archive does not contain a valid metada.json file

fjrg76-com, 2024-01-02:
Hi, I've just downloaded the project and while attempting to open it with the KiCAD7's PCM manager I got the above error.

Did I miss something? Any hint?

pedrominatel, 2024-01-03:
Hi,

**If you are using macOS:** _Make sure to download the correct zip file and do not extract the files. If you are using macOS and Safari, ensure to that the automatic unzip feature (Open safe files after downloading) is disabled._

zerovijay, 2024-01-04:
use this [link](https://github.com/espressif/kicad-libraries/releases/download/2.0.6/espressif-kicad-addon.zip)
download the zip file

pedrominatel, 2024-01-08:
Any update, @fjrg76-com?

grantgumina, 2024-01-14:
Ran into the same issue and disabling Safari's "auto open" feature worked great.

Navarro-Franco, 2024-01-22:
I found a partial solution.
1) Clone the repo.
`git clone https://github.com/espressif/kicad-libraries`
2) Go to the repo and run the script with python
`cd kicad-libraries/ &&  python package.py`
you should get an output like this:
```
This script helps to generate a new kicad addon release.
It generates the release zip file and the metadata.json
Enter the new addon version (required format: major[.minor[.patch]]):

```
3) Enter a version like 2.0.7
`Enter the new addon version (required format: major[.minor[.patch]]): 2.0.7`
( note: it must be higher than the version you download, in my case, the latest version is the 2.0.6)
The script will generate a folder called " build " and a zip file with a valid metada.json

pedrominatel, 2024-01-23:
Use this link to download the latest version.

### [Download here the latest library!](https://github.com/espressif/kicad-libraries/releases/latest/download/espressif-kicad-addon.zip)

Do not unzip the file and zip again and disable the auto-open/opan-safe function on Safari.

dacut, 2024-01-31:
I encountered this myself (on Chrome). In my case, my mistake was going to the Tags and selecting the zip link under the 2.0.6 tag, because GitHub hides the releases off to the side of the UI. This issue helped me find the right link to use.

Closed 2024-05-29.

Thread 149 (2024-02-17):

Missing symbol and footprint for ESP32-C6-WROOM-1U

MatthiasKunnen, 2024-02-17:
The U variant (external antenna) symbol and footprint is missing from the component library.
The 3D model is already present.

I presume the non-U symbol is the same and the ESP32-C6-WROOM-1 could be renamed to ESP32-C6-WROOM-1/U, same as the C6-MINI.

ESP32-C6-WROOM-1U Datasheet: <https://www.espressif.com/sites/default/files/documentation/esp32-c6-wroom-1_wroom-1u_datasheet_en.pdf>

Closed 2024-02-26.

Thread 152 (2024-02-22):

KiCad 6 Footprint problems

IGD-james, 2024-02-22:
Hi,

The symbols seem to work OK on the legacy Kicad 6 branch.

However, some of the footprints seem to be made with a newer version of Kicad and it gives an error telling to update to a newer version.

I am on Kicad 6.0.11

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

A picture of the footprints that work and import successfully:
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

Error when importing ESP32-C3-WROOM-02 footprint:

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

Thread 153 (2024-02-25):

KiCad 8 - wrong path for 3D models

cgreening, 2024-02-25:
The 3D models seem to refer to `KICAD7_3RD_PARTY` which stops the 3D models working in KiCad 8.

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

cgreening, 2024-02-25:
Might be possible to modify the build script so that it generates both KiCad 7 and KiCad 8 libraries.

Closed 2024-02-28.

Thread 155 (2024-02-28):

Fix ESP32-H2-MINI symbol PCM path

pedrominatel, 2024-02-28:
Fix ESP32-H2-MINI symbol PCM path

MatthiasKunnen, 2024-03-01:
Sorry, incorrect mention. I thought this issue was about the non-MINI H2 footprint. I'll have a look at the symbol.

Closed 2024-03-02.

Thread 157 (2024-02-29):

Adjust the library download link to the correct release on the legacy branches

pedrominatel, 2024-02-29:
Adjust the library download link to the correct release on the legacy branches.

- [ ] KiCad 6
- [ ] KiCad 7

mrWheel, 2024-10-27:
And what about KiCad 8 ?

Thread 158 (2024-02-29):

Update the KiCad version to 8.0.0

pedrominatel, 2024-02-29:
https://github.com/espressif/kicad-libraries/blob/842c0fa84e1f3430de90817139adf464a93694ee/package.py#L39

Zeni241, 2024-03-10:
Still some glitches when used with KiCAD8.

Closed 2024-04-12.

Thread 162 (2024-03-03):

Add the symbol, footprint and 3d model for ESP32-S3-WROOM-2(U)

ONLYA, 2024-03-03:
Please add the models for ESP32-S3-WROOM-2 and ESP32-S3-WROOM-2U modules.
Thanks.

pedrominatel, 2024-03-04:
Hi,
The module is supported, please check it [here](https://github.com/espressif/kicad-libraries/blob/main/footprints/Espressif.pretty/ESP32-S3-WROOM-2.kicad_mod).

Thread 164 (2024-04-11):

ESP32 Devkit 30GPIO pin error.

Marckkill, 2024-04-11:
There is an error on the symbol. Pin 21 and 22 are labeled the same GPIO32.
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

pedrominatel, 2024-04-12:
Can you please confirm the library version you're using?

Closed 2024-05-29.

Thread 171 (2024-07-25):

Support for ESP32-C3-mini development board

EvEggelen, 2024-07-25:
Would it be possible to add support for the following board ?

https://www.aliexpress.com/item/1005007250663964.html

Zealota74, 2025-02-10:
[ESP32-C3_SUPERMINI_SMD.zip](https://github.com/user-attachments/files/18741634/ESP32-C3_SUPERMINI_SMD.zip)

[ESP32-C3 SuperMini--3DModel-STEP-56544.zip](https://github.com/user-attachments/files/18741638/ESP32-C3.SuperMini--3DModel-STEP-56544.zip)
Generated from:
https://www.snapeda.com/parts/ESP32-C3%20SuperMini_SMD/Espressif%20Systems/view-part/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

Thread 173 (2024-10-08):

Specify pad to die length of modules and IC's

Somososan, 2024-10-08:
### Checklist

- [X] Checked the issue tracker for similar issues to ensure this is not a duplicate.
- [X] Described the feature in detail and justified the reason for the request.
- [X] Provided specific use cases and examples.

### Feature description

KiCad provides the option to specify the pad to die length in it's footprint. To match signals on a PCB the length inside the modules and the IC package should be taken into account. (Better would be providing a time delay per pad but this is currently unsupported by KiCad)

### Use cases

Matching of signals like LCD Modules or higher capacity external PSRAM

### Alternatives

Available making of IBIS files on the site

### Additional context

_No response_

Thread 174 (2024-10-08):

VRML models do not work

doragasu, 2024-10-08:
### Checklist

- [X] Checked the issue tracker for similar issues to ensure this is not a duplicate
- [X] Read the documentation to confirm the issue is not addressed there and your configuration is set correctly
- [X] Tested with the latest version to ensure the issue hasn't been fixed

### How often does this bug occurs?

always

### Expected behavior

To be able to export complete PCBs to VRML, the 3D models must be in VRML format. By default footprints in this library link to the STEP 3D models. If you switch a model from STEP to VRML (WRL), KiCAD does not show the model (at least the KiCad release 8.0.5 I'm running).

### Actual behavior (suspected bug)

When switching from the STEP 3D models to the VRML 3D models, the VRML model should be shown, but nothing is shown.

### Error logs or terminal output

_No response_

### Steps to reproduce the behavior

Previously to these steps, you should have the Espressif Library plugin installed.

1. Open KiCad Footprint Editor
2. Open any module from `PCM_Espressif` library. E.g.: `ESP32-C3-WROOM-02`.
3. Switch to 3D view (press ALT+3). The 3D module shows properly.
4. Close the 3D viewer and in the Footprint Editor open the Footprint Properties dialog (Click File / Footprint Properties...).
5. Go to the 3D Models tab.
6. Change the model path to point to the VRML version (e.g.: `${KICAD8_3RD_PARTY}/3dmodels/com_github_espressif_kicad-libraries/espressif.3dshapes/ESP32-C3-WROOM-02.wrl`).
7. The 3D model is not shown.

This problem happens with all VRML files I tested in the Espressif Library. VRML files included with KiCad libraries load without a problem.

The bug also happens in the PCB Editor and prevents the full PCBs to be exported to VRML correctly.

### Project release version

Latest release 3.0.1, and KiCad 8.0.5

### System architecture

Intel/AMD 64-bit (modern PC, older Mac)

### Operating system

Linux

### Operating system version

ArchLinux

### Shell

Bash

### Additional context

_No response_

ToonVanEyck, 2024-12-30:
I also ran into this issue today. Is there any update regarding this?

Thread 176 (2024-12-07):

Support for ESP32-S2-MINI-2-N4R2

PostulkaJiri, 2024-12-07:
### Checklist

- [X] Checked the issue tracker for similar issues to ensure this is not a duplicate.
- [X] Described the feature in detail and justified the reason for the request.
- [X] Provided specific use cases and examples.

### Feature description

Could be possible to add new footprint and symbol for [ESP32-S2-MINI-2-N4R2](https://www.espressif.com/sites/default/files/documentation/esp32-s2-mini-2_esp32-s2-mini-2u_datasheet_en.pdf)

### Use cases

Support of device pro Espressif family

### Alternatives

_No response_

### Additional context

_No response_

pedrominatel, 2024-12-30:
Thank you for your request, @PostulkaJiri.
We will work more actively on this library from the beginning of 2025.

Thread 178 (2025-01-06):

ESP32-P4 pin swapped

PickaxeHit, 2025-01-06:
### Checklist

- [X] Checked the issue tracker for similar issues to ensure this is not a duplicate
- [X] Read the documentation to confirm the issue is not addressed there and your configuration is set correctly
- [X] Tested with the latest version to ensure the issue hasn't been fixed

### How often does this bug occurs?

always

### Expected behavior

none

### Actual behavior (suspected bug)

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

### Error logs or terminal output

_No response_

### Steps to reproduce the behavior

Install the package and open ESP32-P4 symbol and it's here.

### Project release version

v3.0.1 release

### System architecture

Intel/AMD 64-bit (modern PC, older Mac)

### Operating system

Linux

### Operating system version

arch+kicad8.0.7

### Shell

ZSH

### Additional context

The positions of GPIO5 and GPIO6 are swapped (although they still correspond to the pin numbers, they do not meet the design specifications)

pedrominatel, 2025-01-07:
Thank you very much for your issue report.
This is indeed a bug and it will be fixed as soon as possible.

pedrominatel, 2025-01-07:
> Thank you very much for your issue report. This is indeed a bug and it will be fixed as soon as possible.

This bug has no impact on the footprint, the pin number, and the GPIO matches. The issue is only the order on the symbol.

Closed 2025-01-09.

Thread 180 (2025-01-20):

KiCad 8.0 on OSX zip import error

masonhensley, 2025-01-20:
### Checklist

- [x] Checked the issue tracker for similar issues to ensure this is not a duplicate
- [x] Read the documentation to confirm the issue is not addressed there and your configuration is set correctly
- [x] Tested with the latest version to ensure the issue hasn't been fixed

### How often does this bug occurs?

always

### Expected behavior

Hi,

1. Fresh install of KiCad.
2. Fresh download of zip from this github repo.

Received this error: `Archive does not contain a valid metadata.json file`

I'm a little new to the KiCad ecosystem, so my casual inspection of the metadata.json did not raise any immediate red flags.

### Actual behavior (suspected bug)

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

### Error logs or terminal output

```shell
Archive does not contain a valid metadata.json file
```

### Steps to reproduce the behavior

1. Open KiCad
2. download zip from this github repo
3. In KiCad splash screen, click "Plugin And Content Manager"
4. Click "Install from file" button in lower right corner
5. Select zip from this repo from my download folder
6. Error pops up

### Project release version

latest

### System architecture

ARM 64-bit (Apple M1/M2, Raspberry Pi 4/5)

### Operating system

MacOS

### Operating system version

15.1 Beta (24B5077a)

### Shell

ZSH

### Additional context

_No response_

masonhensley, 2025-02-26:
@pedrominatel - downloading the build via the releases fixed this error for me.

Closed 2025-02-26.

Thread 187 (2025-05-12):

ESP32-C3-MINI-1U not included in Espressif.kicad_sym

DarranShepherd, 2025-05-12:
### Checklist

- [x] Checked the issue tracker for similar issues to ensure this is not a duplicate
- [x] Read the documentation to confirm the issue is not addressed there and your configuration is set correctly
- [x] Tested with the latest version to ensure the issue hasn't been fixed

### How often does this bug occurs?

always

### Expected behavior

I expected to be able to select ESP32-C3-MINI-1U when placing a symbol on a schematic.

### Actual behavior (suspected bug)

The ESP32-C3-MINI-1 module is available, but the ESP32-C3-MINI-1U is not.

### Error logs or terminal output

```shell

```

### Steps to reproduce the behavior

Install the library in Kicad 8.0.9
Click Place Symbol on the schematic editor
Search for ESP32-C3-MINI
ESP32-C3-MINI-1 is available, but ESP32-C3-MINI-1U is not

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

### Project release version

3.0.2

### System architecture

Intel/AMD 64-bit (modern PC, older Mac)

### Operating system

Windows

### Operating system version

Windows 11

### Shell

PowerShell

### Additional context

I can see the footprint and 3d model files, but noticed that the ESP32-C3-MINI-1U is not included in the symbols file. I manually edited the file to copy the ESP32-C3-MINI-1 symbol and replaced ESP32-C3-MINI-1 with ESP32-C3-MINI-1U where necessary and this does now show up when choosing a symbol, but the pads are inset from the edge of the package and I'm very much out of my depth at this point...

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

Apologies if this is a beginner user mistake.

DarranShepherd, 2025-05-12:
I can now see that the inset pads on one edge matches the datasheet, so perhaps my manual edit of the Espressif.kicad_sym file is sufficient?

kozmotronik, 2025-07-25:
+1. I need to use the `ESP32-C3-MINI-1U` in a PCB. The only module missing in the `symbols` library. Although the pins are identical for both, using the `ESP32-C3-MINI-1` in the schematic and the `ESP32-C3-MINI-1U` in the PCB may lead to confusions. So please consider adding the `symbol` as well.

Kind regards

Thread 189 (2025-06-04):

ESP32-P4 symbol has incorrect default footprint field

subrootdev, 2025-06-04:
### Checklist

- [x] Checked the issue tracker for similar issues to ensure this is not a duplicate
- [x] Read the documentation to confirm the issue is not addressed there and your configuration is set correctly
- [x] Tested with the latest version to ensure the issue hasn't been fixed

### How often does this bug occurs?

always

### Expected behavior

The ESP32-P4 symbol in the KiCad library should correctly reference the footprint:
`PCM_Espressif:ESP32-P4`

### Actual behavior (suspected bug)

The symbol currently references:
`PCM_Espressif:Espressif:ESP32-P4`

### Error logs or terminal output

```shell
Invalid footprint specified
(Displayed in the footprint preview area in KiCad)
```

### Steps to reproduce the behavior

1- Clone or install the Espressif KiCad libraries

2- Open KiCad 9 and place the ESP32-P4 symbol in the schematic

3- Observe the footprint field set to: PCM_Espressif:Espressif:ESP32-P4

4- See the error message: “Invalid footprint specified”

5- Manually correcting it to PCM_Espressif:ESP32-P4 resolves the issue

### Project release version

latest

### System architecture

ARM 64-bit (Apple M1/M2, Raspberry Pi 4/5)

### Operating system

MacOS

### Operating system version

Sequoia 15.5

### Shell

Bash

### Additional context

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

Closed 2025-10-07.

Thread 190 (2025-07-03):

Already Kicad 9, any plan?

jiapei100, 2025-07-03:
### Checklist

- [x] Checked the issue tracker for similar issues to ensure this is not a duplicate.
- [x] Described the feature in detail and justified the reason for the request.
- [x] Provided specific use cases and examples.

### Feature description

Expecting a Kicad 9 compatible version of esp32/esp8266 libraries.

### Use cases

Expecting a Kicad 9 compatible version of esp32/esp8266 libraries.

### Alternatives

_No response_

### Additional context

_No response_

jiapei100, 2025-07-03:
Sorry, got it here:

https://github.com/espressif/kicad-libraries/issues/183#issuecomment-2801116045

Closed 2025-07-03.

Thread 191 (2025-08-27):

Add automatic KiCad PCM index for this library

sivakov512, 2025-08-27:
### Checklist

- [x] Checked the issue tracker for similar issues to ensure this is not a duplicate.
- [x] Described the feature in detail and justified the reason for the request.
- [x] Provided specific use cases and examples.

### Feature description

Currently, Espressif’s KiCad libraries are already packaged as valid KiCad PCM packages, but they are not distributed through a PCM index. This means users cannot install them directly from KiCad’s Content Manager.

I propose to set up a separate espressif/kicad-pcm-index repository that hosts an index file and is automatically updated on each new release of this library (e.g. via GitHub Actions). This would allow users to simply add the Espressif index once and always have access to the latest version through the built-in PCM interface.

I’d be happy to help set up the automation and repository if you find this approach useful.

### Use cases

•	Developers can install and update Espressif KiCad libraries directly from KiCad’s Content Manager.
•	No manual download or setup required.
•	Always stays in sync with the latest official release.

### Alternatives

If you prefer not to maintain that, that’s fine too — I’ll just keep mirroring the library in my [personal PCM index](https://github.com/sivakov512/kicad-pcm-index).

### Additional context

_No response_
