espressif/kicad-libraries/(commit log)

2021-06-25 Added first libraries (symbols and footprints) and 3d models
2021-07-14 Added legacy footprints for KiCad V5
2021-07-16 Fix using KLC check on footprints
2021-07-16 Added ESP32-S3 modules footprints
2021-07-16 Added ESP32-S3 modules symbols
2021-07-19 add DevKit board ESP32-DevKitc and ESP32-S3-DevKitc
2021-07-19 Minor changes on the DevKitC for ESP32 and S3 plus more description on S3 modules
2021-07-23 Revision done on symbols (ESP32, C3 and S2)
2021-07-26 Symbols review and added ESP32-S2-SOLO module footprint
2021-07-26 Added ESP32-S2-SOLO symbol and minor review on symbols
2021-07-26 README file updated with the ESP32-S2-SOLO information
2021-08-08 ESP32-C3-WROOM-02: GND pins were marked as power output rather than power input ESP32-S2, ESP32-S2-MINI-1: TXD/RXD were marked as input/output, but they're bidirectional GPIOs ESP32-S2-SOLO: GPIO46 w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
2021-08-10 Fix on ESP32-S3-WROOM-1 module name
2021-08-13 Removed S3 SoC and modules due changes on the SoC pin mapping
2021-08-21 Fixed ESP32 WROOM and WROVER modules
2021-11-02 new: Added ESP32-S3 footprint and symbol
2021-11-02 new: Added ESP32-C3-MINI-1U footprint
2021-11-10 ESP32-S3-MINI symbol name fixed
2021-12-13 [Bug Fix] Fixed pin connection on GPIO16 and GPIO17
2022-01-31 Fixed ESP32-WROOM-E typo
2022-03-04 Port to KiCad 6 and fixes on modules and footprints. New 3D files added.
2022-03-04 Update on the README to KiCad 6
2022-03-04 Added ESP8685 symbol and ESP32-C3-WROOM-02U footprint and 3D model
2022-03-07 Added ESP32-WROOM template
    [esp32-wroom_template.kicad_pcb, esp32-wroom_template.kicad_sch]
2022-03-07 Added ESP32-DevKitC template
    [esp32-devkitc_template.kicad_pcb, esp32-devkitc_template.kicad_sch]
